jamesgao/kiln_controller/README.md

Raspberry Pi controlled Kiln
============================

This project implements a wifi-accessible temperature controller for a ceramic firing kiln.

Please see the BOM for all the parts we purchased for this project. Additional circuit diagrams and 3D models will be forthcoming.
