jamesgao/kiln_controller/circuits/pcb_eagle.png

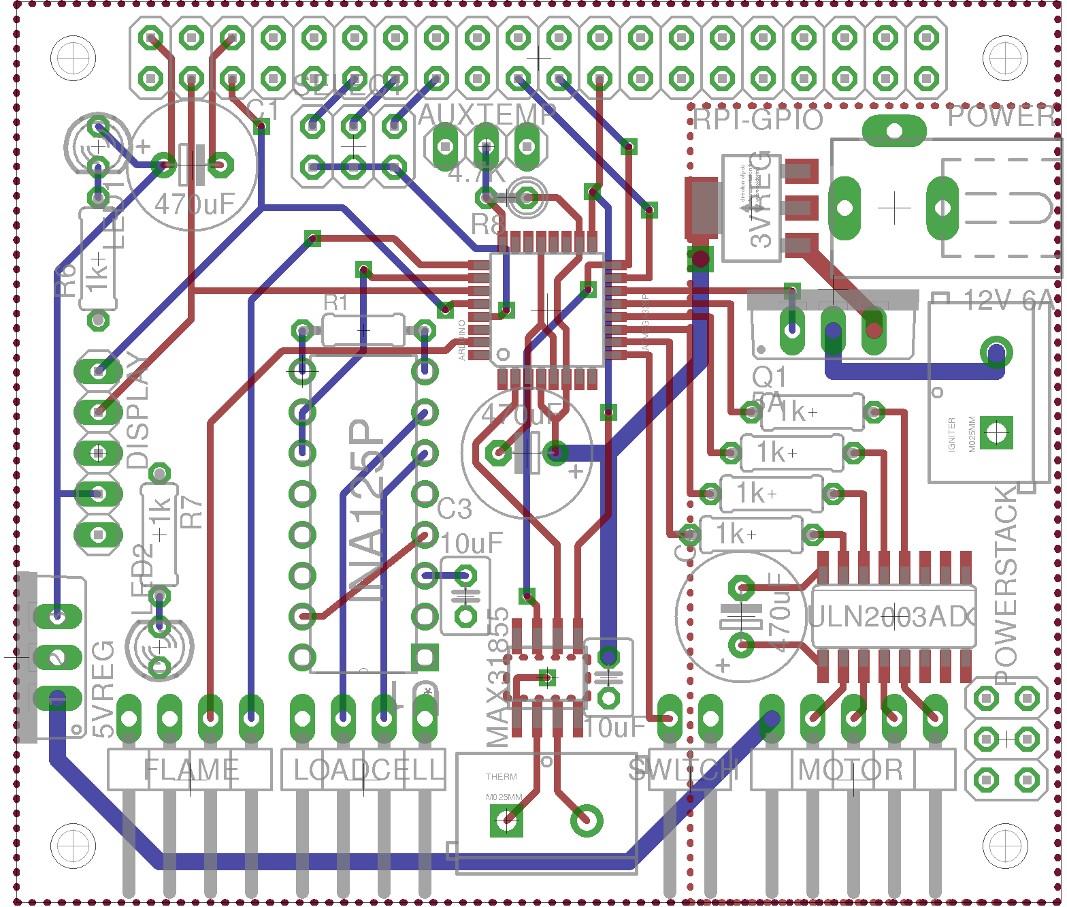
circuits/pcb_eagle.png
