jamesgao/kiln_controller/circuits/pcb_top.png

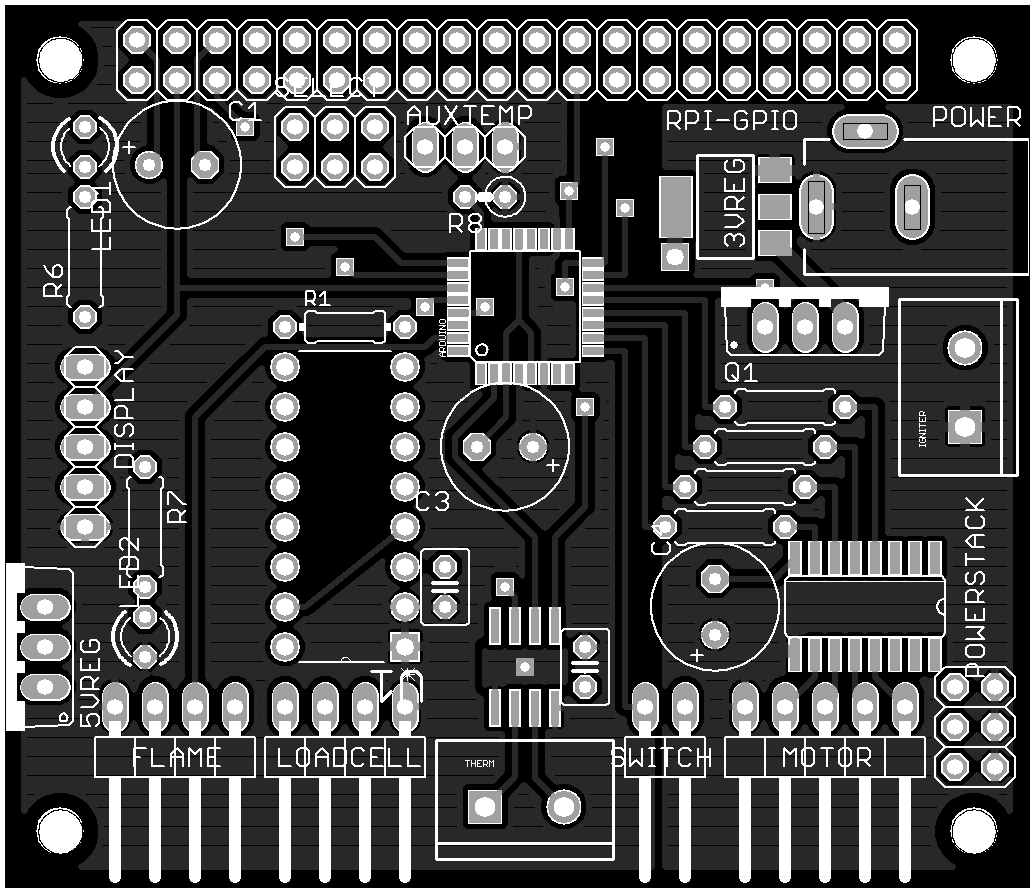
circuits/pcb_top.png
