jamesgao/kiln_controller/BOM.md

| Item | Where | Price |
|---|---|---:|
| Kiln | Craigslist| $100.00  |
|MR-750 Venturi Burner | [Link](http://www.axner.com/mr-750venturiburner.aspx) (locally purchased)| $43.50|
|Propane regulator|[Link](http://www.ebay.com/itm/331092530323?_trksid=p2060778.m2749.l2649&ssPageName=STRK%3AMEBIDX%3AIT)| $17.66|
|Various connectors| Hardware store | $10.00 |
|K-type kiln thermocouple with block|[Link](http://www.ebay.com/itm/291255615336?_trksid=p2060778.m2749.l2649&ssPageName=STRK%3AMEBIDX%3AIT)| $21.00|
|K-type thermocouple wire|[Link](http://www.amazon.com/gp/product/B00AKWP0BW/ref=oh_aui_detailpage_o03_s00?ie=UTF8&psc=1)| $9.11 |
|Raspberry Pi|[Link](http://www.newegg.com/Product/Product.aspx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)|$35.00|
|USB Wifi adapter|[Link](http://www.amazon.com/Edimax-EW-7811Un-Adapter-Raspberry-Supports/dp/B003MTTJOY)|$8.70|
|MAX31850K breakout|[Link](https://www.adafruit.com/products/1727)|$14.95|
|Alphanumeric LED with backpack|[Link](https://www.adafruit.com/products/1911)|$9.95|
|28BYJ-48 stepper|[Link](http://www.ebay.com/itm/2pcs-DC-5V-Stepper-Motor-ULN2003-Driver-Test-Module-Board-28BYJ-48-for-Arduino-/221347325924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)|$5.00|
|Silicon Nitride igniter|[Link](https://www.sparkfun.com/products/11694)|$19.95|
|Flame Sensor|[Link](http://www.ebay.com/itm/Wavelength-760nm-1100nm-LM393-IR-Flame-Fire-Sensor-Module-Board-For-Arduino-/190938428869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)|$1.50|
|12V 6A power supply|[Link](http://www.amazon.com/Adapter-Power-Supply-LCD-Monitor/dp/B003TUMDWG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)|$6.50|

*Total: $199.81*
