jamesgao/kiln_controller/BOM.ods

Item | Where | Price
Kiln | Craigslist | $100.00
MR-750 Venturi Burner | http://www.axner.com/mr-750venturiburner.aspx (locally purchased) | $43.50
Propane regulator | http://www.ebay.com/itm/331092530323?_trksid=p2060778.m2749.l2649&ssPageName=STRK%3AMEBIDX%3AIT | $17.66
Various connectors for regulator | Ace hardware | $10.00
K-type kiln thermocouple with block | http://www.ebay.com/itm/291255615336?_trksid=p2060778.m2749.l2649&ssPageName=STRK%3AMEBIDX%3AIT | $21.00
K-type thermocouple wire | http://www.amazon.com/gp/product/B00AKWP0BW/ref=oh_aui_detailpage_o03_s00?ie=UTF8&psc=1 | $9.11
Raspberry Pi | http://www.newegg.com/Product/Product.aspx?Item=N82E16813142003&nm_mc=KNC-GoogleAdwords-PC | $35.00
USB Wifi Adapter | http://www.amazon.com/Edimax-EW-7811Un-Adapter-Raspberry-Supports/dp/B003MTTJOY | $8.70
MAX31850K breakout | https://www.adafruit.com/products/1727 | $14.95
Alphanumeric LED | https://www.adafruit.com/products/1911 | $9.95
28BYJ-48 Stepper | http://www.ebay.com/itm/2pcs-DC-5V-Stepper-Motor-ULN2003-Driver-Test-Module-Board-28BYJ-48-for-Arduino-/221347325924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 | $5.00
Silicon nitride igniter | https://www.sparkfun.com/products/11694 | $19.95
Solid state relay | http://www.ebay.com/itm/141242782486?_trksid=p2060778.m2749.l2649&ssPageName=STRK%3AMEBIDX%3AIT | $3.49
Flame Sensor | http://www.ebay.com/itm/Wavelength-760nm-1100nm-LM393-IR-Flame-Fire-Sensor-Module-Board-For-Arduino-/190938428869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 | $1.50
12V 6amp power supply | http://www.amazon.com/Adapter-Power-Supply-LCD-Monitor/dp/B003TUMDWG | $6.50
 | Total | $199.81
