jamesgao/kiln_controller/models/regulator_vert.stl

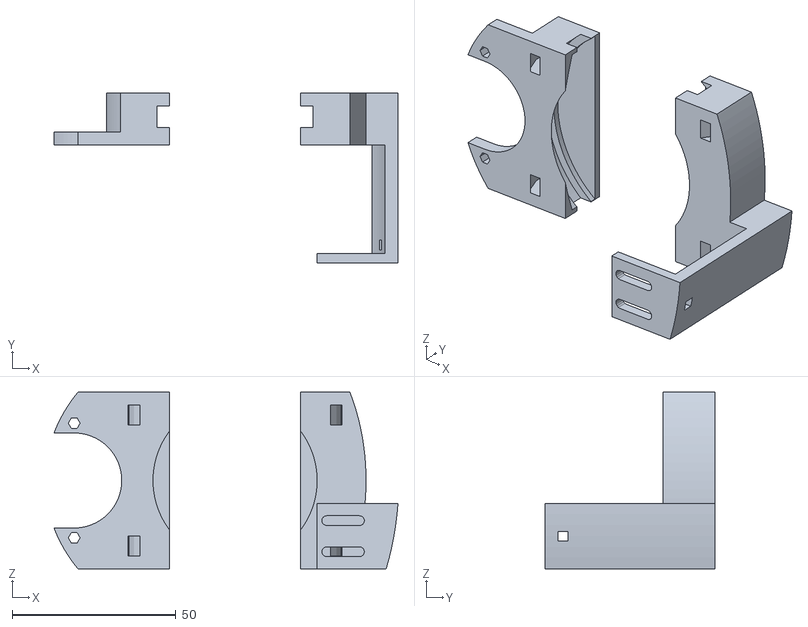
[picture p3: CAD file, 2014-11-30]
models/regulator_vert.stl
105.0 x 52.0 x 54.0
