jamesgao/kiln_controller/models/bracket.stl

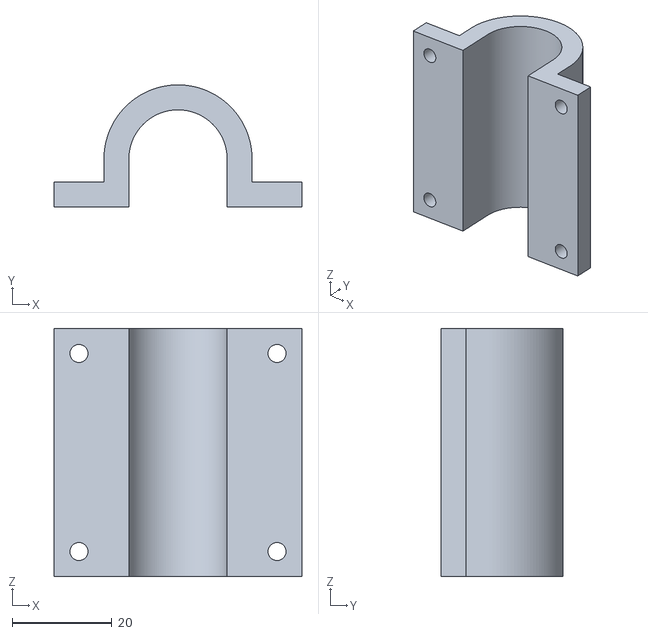
[picture p4: CAD file, 2014-10-17]
models/bracket.stl
49.7 x 24.5 x 49.7
