jamesgao/kiln_controller/models/gears.stl

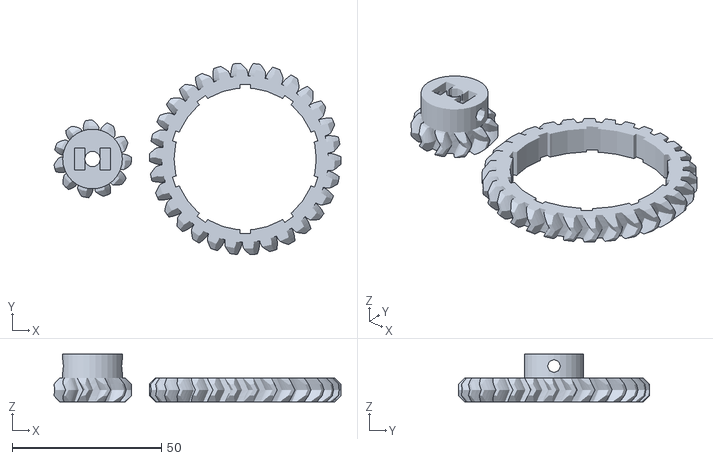
[picture p5: CAD file, 2014-10-17]
models/gears.stl
96.1 x 64.1 x 16.0
