jamesgao/kiln_controller/(list of files, cad)

Other CAD files:
models/involute_gears.scad
