jamesgao/kiln_controller/(threads)

Thread 9 (2015-06-26):

Does this code run?  Where is manager.KilnController?

Permafacture, 2015-06-26:
I'm looking at extending this code to be a more general purpose PID for kilns (Electric, propane, forced air over coals), but looking at it I see that the bisque_firing_06.py calls manager.KilnController.  But there is no KilnController Class in manager.py, or anywhere that I see.  Is this supposed to be manager.Manager?

jgimbel, 2015-06-27:
I can confirm that in February bisque_firing_06.py was working. I have not updated since then.

Permafacture, 2015-06-27:
I don't have the hardware to test this code (and won't since I'll be working with an electric kiln) but can you explain how
```
import manager
manager.KilnController(...)
```
is not an AttributeError?

Is it something that you created dynamically through the web interface or something?  If this code does run, I'd appreciate some insight.

Permafacture, 2015-06-27:
Everything looks good in general.  I like your use of threads and project layout.  Seems easily extensible.  I'm looking forward to working on this and testing it with some kilns! I have a feeling that there's an insignificant change to `manager.py` that you forgot to push though.

Thanks for this!

jamesgao, 2015-06-27:
Glad the code can be of use! I should really take some time and document this code -- there's actually a full blown web interface for controlling the kiln. If you run `python server.py` from the kiln subdirectory then navigate to http://localhost:8888/, you get a full blown temperature plot with some simple controls.

Permafacture, 2015-06-30:
So, I am working on extending this code to work on an electric kiln.  There's a lot of propane specific heuristics built in that I would like to extract out rather than just deleting.  However, I don't have a propane system to test any changes I make.  Would you be interest in me opening bugs, getting guidance from you, and making pull requests anyways?

I've opened bugs on my fork to show what I would like to do.  Feedback appreciated:

https://github.com/Permafacture/kiln_controller/issues

Thread 10 (2015-09-17):

Stepper scad file missing

jgimbel, 2015-09-17:
In regulator.scad the file '../lib/28byj.scad' is used on line 2 is missing from the git project. Adding it to the repo would help me adjust regulator.scad.
