jamesgao/kiln_controller/circuits/kiln_rpi_breakout_atmega328.brd

## EAGLE design circuits/kiln_rpi_breakout_atmega328.brd (2014-11-27)

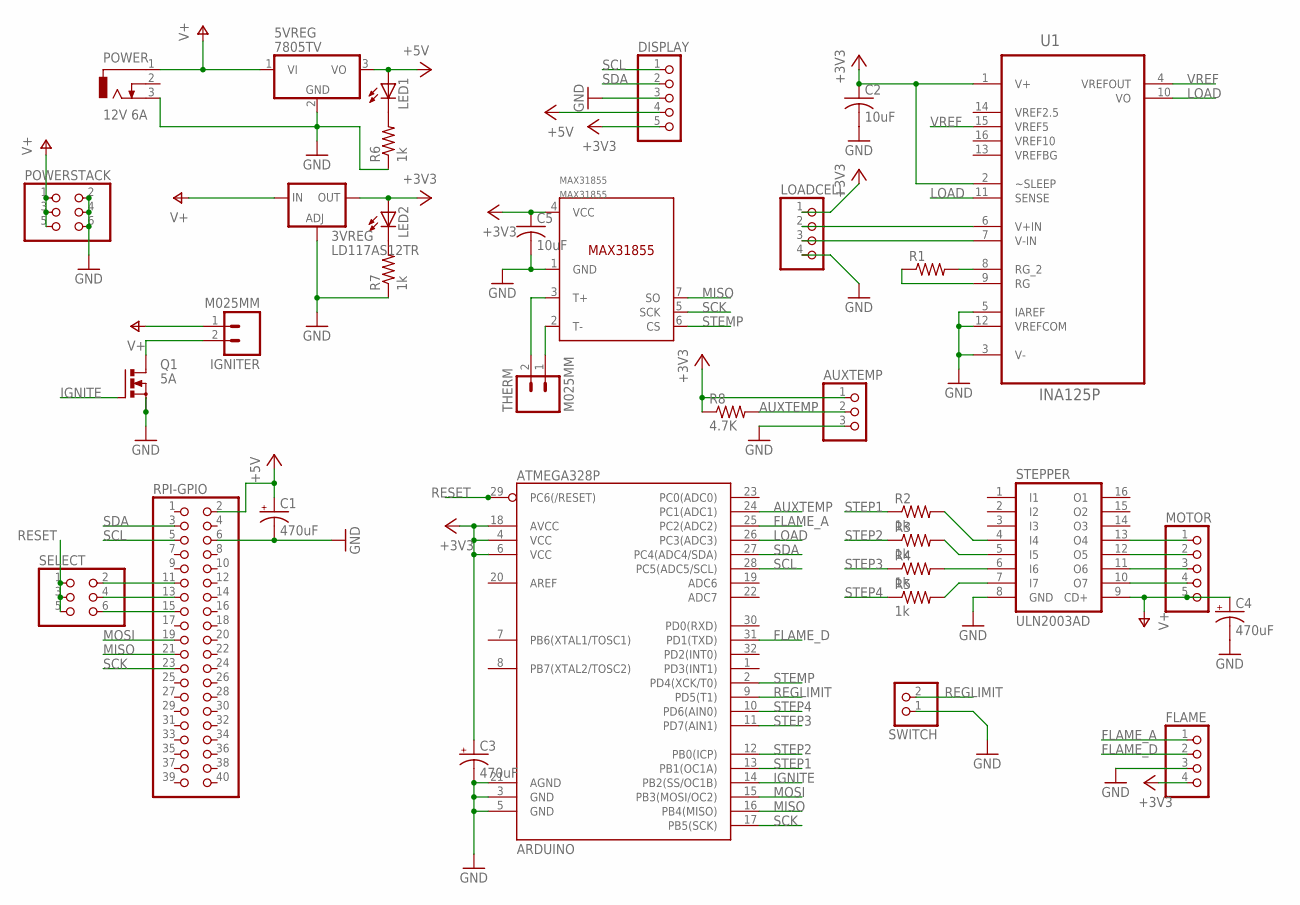
[picture p6: schematic kiln_rpi_breakout_atmega328.sch]

Parts:
3VREG: LD117AS12TR; SOT223
5VREG: 7805TV; TO220V
ARDUINO: ATMEGA328P; TQFP32-08
AUXTEMP: PINHD-1X3; 1X03
C1, C3, C4: 470uF; E3,5-8
C2, C5: 10uF; C025-030X050
DISPLAY: PINHD-1X5; 1X05
FLAME: PINHD-1X4/90; 1X04/90
IGNITER: M025MM; SCREWTERMINAL-5MM-2
LED1, LED2: LED3MM
LOADCELL: PINHD-1X4/90; 1X04/90
MAX31855: MAX31855; SOIC8
MOTOR: PINHD-1X5/90; 1X05/90
POWER: 12V 6A; DCJ0303
POWERSTACK: PINHD-2X3; 2X03
Q1: 5A; TO220BV
R1: R-US_0204/7; 0204/7
R2, R3, R4, R5, R6, R7: 1k; 0207/7
R8: 4.7K; 0207/2V
RPI-GPIO: PINHD-2X20; 2X20
SELECT: PINHD-2X3; 2X03
STEPPER: ULN2003AD; SO16
SWITCH: PINHD-1X2/90; 1X02/90
THERM: M025MM; SCREWTERMINAL-5MM-2
U1: INA125P; DIP254P762X508-16

Connections:
+3V3: 3VREG.4 (OUT), ARDUINO.4 (VCC), ARDUINO.6 (VCC), ARDUINO.18 (AVCC), AUXTEMP.1, C2.1, C3.+, C5.1, DISPLAY.5, FLAME.4, LED2.A, LOADCELL.1, MAX31855.4 (VCC), R8.1, U1.1 (V+), U1.2 (~SLEEP)
+5V: 5VREG.3 (VO), C1.+, DISPLAY.4, LED1.A, RPI-GPIO.2
AUXTEMP: ARDUINO.24 (PC1(ADC1)), AUXTEMP.2, R8.2
FLAME_A: ARDUINO.25 (PC2(ADC2)), FLAME.1
FLAME_D: ARDUINO.31 (PD1(TXD)), FLAME.2
GND: 3VREG.1 (ADJ), 5VREG.2 (GND), ARDUINO.3 (GND), ARDUINO.5 (GND), ARDUINO.21 (AGND), AUXTEMP.3, C1.-, C2.2, C3.-, C4.-, C5.2, DISPLAY.3, FLAME.3, LOADCELL.4, MAX31855.1 (GND), POWER.3, POWERSTACK.2, POWERSTACK.4, POWERSTACK.6, Q1.S, R6.1, R7.1, RPI-GPIO.6, STEPPER.8 (GND), SWITCH.1, U1.3 (V-), U1.5 (IAREF), U1.12 (VREFCOM)
IGNITE: ARDUINO.14 (PB2(SS/OC1B)), Q1.G
LOAD: ARDUINO.26 (PC3(ADC3)), U1.10 (VO), U1.11 (SENSE)
MISO: ARDUINO.16 (PB4(MISO)), MAX31855.7 (SO), RPI-GPIO.21
MOSI: ARDUINO.15 (PB3(MOSI/OC2)), RPI-GPIO.19
unnamed: MOTOR.1, STEPPER.13 (O4)
unnamed: MOTOR.2, STEPPER.12 (O5)
unnamed: MOTOR.3, STEPPER.11 (O6)
unnamed: MOTOR.4, STEPPER.10 (O7)
unnamed: LED1.K (C), R6.2
unnamed: LOADCELL.2, U1.6 (V+IN)
unnamed: LOADCELL.3, U1.7 (V-IN)
unnamed: MAX31855.3 (T+), THERM.2
unnamed: IGNITER.2, Q1.D
unnamed: R1.2, U1.8 (RG_2)
unnamed: R5.2, STEPPER.7 (I7)
unnamed: R4.2, STEPPER.6 (I6)
unnamed: R3.2, STEPPER.5 (I5)
unnamed: R2.2, STEPPER.4 (I4)
unnamed: R1.1, U1.9 (RG)
unnamed: MAX31855.2 (T-), THERM.1
unnamed: LED2.K (C), R7.2
REGLIMIT: ARDUINO.9 (PD5(T1)), SWITCH.2
RESET: ARDUINO.29 (PC6(/RESET)), SELECT.1, SELECT.3, SELECT.5
RESET1: RPI-GPIO.11, SELECT.2
RESET2: RPI-GPIO.13, SELECT.4
RESET3: RPI-GPIO.15, SELECT.6
SCK: ARDUINO.17 (PB5(SCK)), MAX31855.5 (SCK), RPI-GPIO.23
SCL: ARDUINO.28 (PC5(ADC5/SCL)), DISPLAY.1, RPI-GPIO.5
SDA: ARDUINO.27 (PC4(ADC4/SDA)), DISPLAY.2, RPI-GPIO.3
STEMP: ARDUINO.2 (PD4(XCK/T0)), MAX31855.6 (CS)
STEP1: ARDUINO.13 (PB1(OC1A)), R2.1
STEP2: ARDUINO.12 (PB0(ICP)), R3.1
STEP3: ARDUINO.11 (PD7(AIN1)), R4.1
STEP4: ARDUINO.10 (PD6(AIN0)), R5.1
V+: 3VREG.3 (IN), 5VREG.1 (VI), C4.+, IGNITER.1, MOTOR.5, POWER.1, POWERSTACK.1, POWERSTACK.3, POWERSTACK.5, STEPPER.9 (CD+)
VREF: U1.4 (VREFOUT), U1.15 (VREF5)
VREF2.5: U1.14 (VREF2.5)
VREF10: U1.16 (VREF10)
VREFBG: U1.13 (VREFBG)

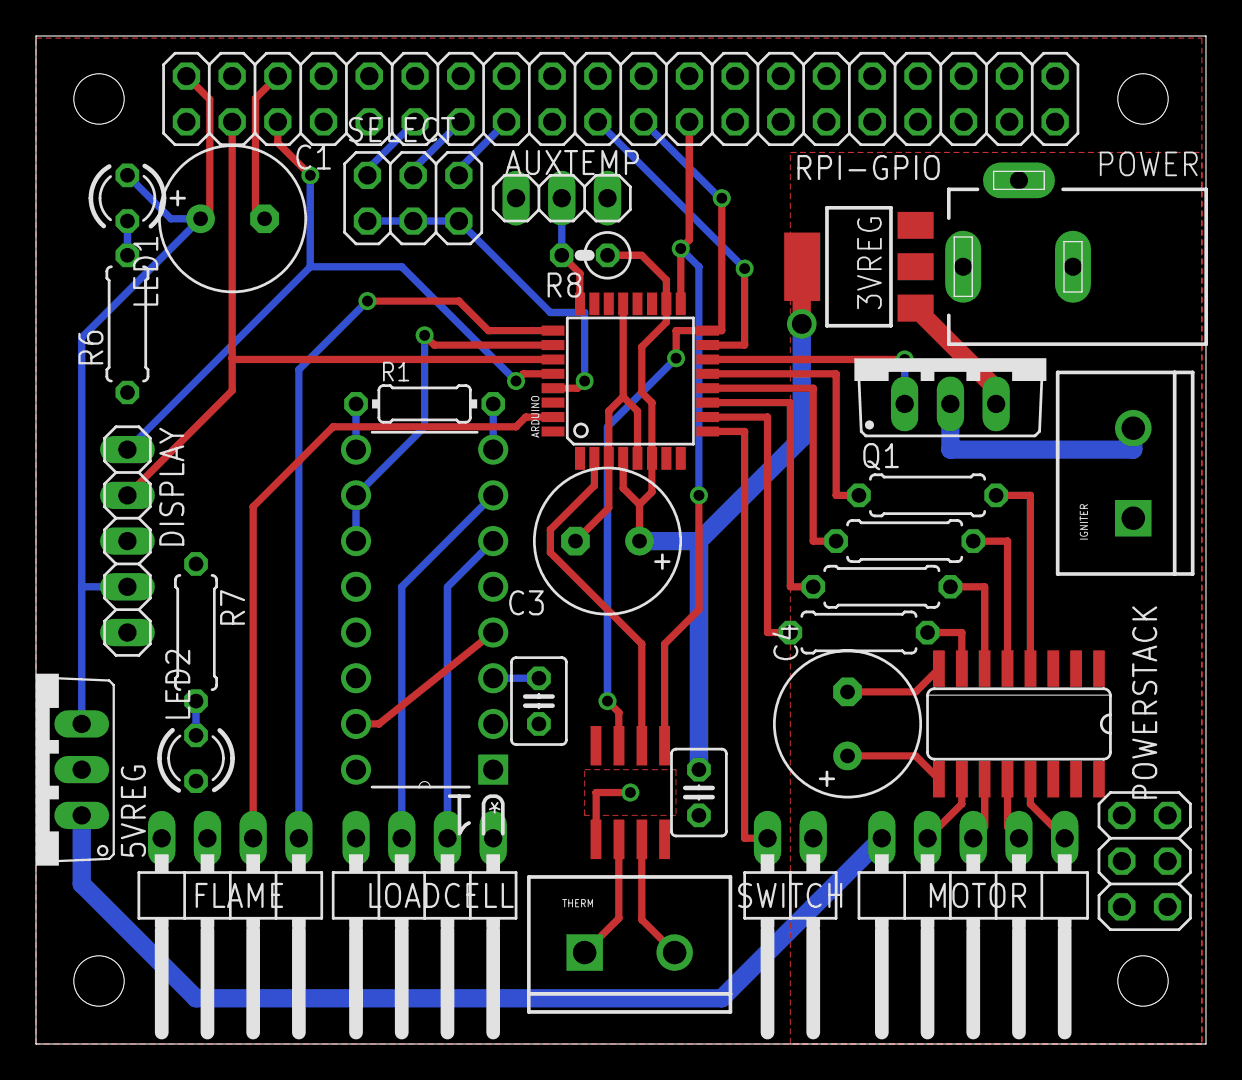
[picture p7: board kiln_rpi_breakout_atmega328.brd from above]

Board: 2 copper layers, 65.0 x 56.0 mm, 34 parts (0 on the bottom side), 42 nets.
