jamesgao/kiln_controller/kiln/Adafruit_alphanumeric.py

#!/usr/bin/python
import threading
import time
import datetime
from Adafruit_LEDBackpack import LEDBackpack

# ===========================================================================
# Alphanumeric Display
# ===========================================================================

# This class is meant to be used with the 4-character alphanumeric
# displays available from Adafruit

class Alphanumeric(object):
    disp = None
 
    # Hexadecimal character lookup table
    lut = [
        0b0000000000000001,
        0b0000000000000010,
        0b0000000000000100,
        0b0000000000001000,
        0b0000000000010000,
        0b0000000000100000,
        0b0000000001000000,
        0b0000000010000000,
        0b0000000100000000,
        0b0000001000000000,
        0b0000010000000000,
        0b0000100000000000,
        0b0001000000000000,
        0b0010000000000000,
        0b0100000000000000,
        0b1000000000000000,
        0b0000000000000000,
        0b0000000000000000,
        0b0000000000000000,
        0b0000000000000000,
        0b0000000000000000,
        0b0000000000000000,
        0b0000000000000000,
        0b0000000000000000,
        0b0001001011001001,
        0b0001010111000000,
        0b0001001011111001,
        0b0000000011100011,
        0b0000010100110000,
        0b0001001011001000,
        0b0011101000000000,
        0b0001011100000000,
        0b0000000000000000, #
        0b0000000000000110, # !
        0b0000001000100000, # "
        0b0001001011001110, # #
        0b0001001011101101, # $
        0b0000110000100100, # %
        0b0010001101011101, # &
        0b0000010000000000, # '
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
                
    special = dict(degree= 0b0000000011100011, cone=0b0010100000001000)
    
    def __init__(self, address=0x70, debug=False):
        self.disp = LEDBackpack(address=address, debug=debug)

    def writeCharRaw(self, charNumber, value):
        "Sets a digit using the raw 16-bit value"
        if (charNumber > 4):
            return
        # Set the appropriate digit
        self.disp.setBufferRow(charNumber, value)

    def writeChar(self, charNumber, value, dot=False):
        "Sets a single decimal or hexademical value (0..9 and A..F)"
        if (charNumber > 4):
            return
        if value in self.special:
            value = self.special[value]
        else:
            value = self.lut[ord(value)]
        # Set the appropriate digit
        self.disp.setBufferRow(charNumber, value | (dot << 14))

class AlphaScroller(threading.Thread):
    def __init__(self, address=0x70, interval=.25):
        self.interval = interval
        self.disp = Alphanumeric(address)
        self.text = ''
        self.counter = 0
        self.pause = threading.Event()
        self.pause.set()
        self.shown = True

        super(AlphaScroller, self).__init__()
        self.running = True

    def stop(self):
        self.pause.set()
        self.running = False
    
    def set_text(self, text, pad=True, reset=True):
        i = 0
        self.text = []
        while i < len(text):
            if i+1 < len(text) and text[i+1] == ".":
                self.text.append((text[i], True))
                i+= 1
            else:
                self.text.append((text[i],))
            i+= 1

        if pad:
            self.text += [(' ',)]*4

        if reset:
            self.counter = 0
    
    def set_speed(self, interval):
        self.interval = interval

    def show(self):
        self.pause.set()
        self.shown = True

    def hide(self):
        self.pause.clear()
        self.clear()
        self.shown = False

    def clear(self):
        for i in range(4):
            self.disp.writeChar(i, ' ')
    
    def run(self):
        while self.running:
            for i in range(4):
                if len(self.text) < 4:
                    char = self.text[i] if i < len(self.text) else (' ',)
                else:
                    char = self.text[(self.counter+i) % len(self.text)]
                if len(char[0]) == 0:
                    print self.text
                self.disp.writeChar(i, *char)
            time.sleep(self.interval)
            self.counter += 1
            self.pause.wait()
        self.clear()

if __name__ == "__main__":
    scroller = AlphaScroller(interval=.4)
    scroller.set_text(list("Hello. World.")+["cone","degree"])
    scroller.start()
    try:
        while scroller.isAlive():
            scroller.join(1)
    except KeyboardInterrupt:
        scroller.stop()
