jamesgao/kiln_controller/kiln/manager.py

import os
import stepper
import time
import random
import thermo
import threading
import traceback
import logging

import states
import PID

logger = logging.getLogger(__name__)
logger.setLevel(logging.INFO)

class TempLog(object):
	def __init__(self, history, interval=60, suffix=""): #save data every 60 seconds
		import paths
		self.history = history
		fname = time.strftime('%Y-%m-%d_%I:%M%P')
		if len(suffix) > 0:
			suffix = "_"+suffix
		self.fname = os.path.join(paths.log_path, fname+suffix+".log")
		with open(self.fname, 'w') as fp:
			fp.write("time\ttemp\n")
			for t, temp in history:
				fp.write("%f\t%f\n"%(t, temp))
		self.next = time.time() + interval
		self.interval = interval
		self._buffer = []

	def __iter__(self):
		return iter(self.history)

	def append(self, data):
		self.history.append(data)
		self._buffer.append(data)
		if time.time() > self.next:
			with open(self.fname, 'a') as fp:
				for t, temp in self._buffer:
					fp.write("%f\t%f\n"%(t, temp))
			self._buffer = []
			self.next = time.time() + self.interval

class Manager(threading.Thread):
	def __init__(self, start=states.Idle, simulate=False):
		"""
		Implement a state machine that cycles through States
		"""
		super(Manager, self).__init__()
		self._send = None
		
		if simulate:
			self.regulator = stepper.Regulator(simulate=simulate)
			self.therm = thermo.Simulate(regulator=self.regulator)
		else:
			self.regulator = stepper.Breakout(0x08)
			self.therm = thermo.Breakout(0x08)

		self.state = start(self)
		self.state_change = threading.Event()

		self.running = True
		self.start()

	def notify(self, data):
		if self._send is not None:
                        try:
			     self._send(data)
                        except:
                             pass
		else:
			logger.info("No notifier set, ignoring message: %s"%data)

	def __getattr__(self, name):
		"""Mutates the manager to return State actions
		If the requested attribute is a function, wrap the function
		such that returned obejcts which are States indicate a state change
		"""
		attr = getattr(self.state, name)
		if hasattr(attr, "__call__"):
			def func(*args, **kwargs):
				self._change_state(attr(*args, **kwargs))
			return func

		return attr

	def _change_state(self, output):
		if isinstance(output, type) and issubclass(output, states.State) :
			self.state = output(self)
			self.state_change.set()
			self.notify(dict(type="state", state=output.__name__))
			logger.info("Switching to state '%s'"%output.__name__)
		elif isinstance(output, tuple) and issubclass(output[0], states.State):
			newstate, kwargs = output
			self.state = newstate(self, **kwargs)
			self.notify(dict(type="state", state=newstate.__name__))
			logger.info("Switching to state '%s'"%newstate.__name__)
		elif isinstance(output, dict) and "type" in output:
			self.notify(output)
		elif output is not None:
			logger.warn("Unknown state output: %r"%output)

	def run(self):
		while self.running:
			self._change_state(self.state.run())
	
	def manager_stop(self):
		self.running = False
		self.state_change.set()

class Profile(threading.Thread):
	"""Performs the PID loop required for feedback control"""
	def __init__(self, schedule, therm, regulator, interval=1, start_time=None, callback=None,
			Kp=.03, Ki=.015, Kd=.001):
		super(Profile, self).__init__()
		self.daemon = True

		self.schedule = schedule
		self.therm = therm
		self.regulator = regulator
		self.interval = interval
		self.start_time = start_time
		if start_time is None:
			self.start_time = time.time()

		self.pid = PID.PID(Kp, Ki, Kd)
		self.callback = callback
		self.running = True
		self.duty_cycle = False
		self.start()

	@property
	def elapsed(self):
		''' Returns the elapsed time from start in seconds'''
		return time.time() - self.start_time

	@property
	def completed(self):
		return self.elapsed > self.schedule[-1][0]

	def stop(self):
		self.running = False

	def run(self):
		_next = time.time()+self.interval
		while not self.completed and self.running:
			ts = self.elapsed
			#find epoch
			for i in range(len(self.schedule)-1):
				if self.schedule[i][0] < ts < self.schedule[i+1][0]:
					time0, temp0 = self.schedule[i]
					time1, temp1 = self.schedule[i+1]
					frac = (ts - time0) / (time1 - time0)
					setpoint = frac * (temp1 - temp0) + temp0
					self.pid.setPoint(setpoint)

					temp = self.therm.temperature.temp
					if temp == -1:
						continue #skip invalid temperature readings
					elif temp - setpoint > 10:
						self.regulator.off()
						self.duty_cycle = True
						pid_out = -1
					elif self.duty_cycle:
						if temp - setpoint < -5:
							self.regulator.ignite()
							self.duty_cycle = False
						pid_out = -1
					else:
						pid_out = self.pid.update(temp)
						if pid_out < 0: pid_out = 0
						if pid_out > 1: pid_out = 1
						self.regulator.set(pid_out)

					if self.callback is not None:
						self.callback(temp, setpoint, pid_out)

			sleep = _next - time.time()
			if sleep > 0:
				time.sleep(sleep)
			_next += self.interval
