jamesgao/kiln_controller/(commit log)

2014-10-15 Implement the stepper-controlled regulator function
2014-10-15 Set up stepper.py for the limits
2014-10-15 Add additional LED code
2014-10-15 Add current thermocouple reading code
2014-10-16 created KilnController class which sets the kiln temperature according to a schedule using PID temperature control
2014-10-16 Adding temp monitor code
    [BOM.ods]
2014-10-16 Fixing threading, dot rendering
    [Adafruit_alphanumeric.py, thermo.py]
2014-10-16 Working thermo.py with LED scroller
2014-10-16 Only display temperature above 50 C
2014-10-17 update nonblocking stepper, damn is bootstrap sexy
2014-10-17 working on d3 graph for temperature
2014-10-17 Add the scad and stl files for kiln parts
    [bracket.scad, bracket.stl, gears.scad, gears.stl, involute_gears.scad, regulator.scad, regulator_vert.stl, utils.scad]
2014-10-18 Forgot to fix the thermocouple display
    [thermo.py]
2014-10-18 Fix bugs in stepper
    [stepper.py]
2014-10-18 Still fixing small bugs in stepper, now tested
    [stepper.py]
2014-10-18 Add a bunch of simulation code to test PID
2014-10-18 add temperature logging with a file
2014-10-20 testing temperature streaming
2014-10-20 working server for streaming temperature data
2014-10-20 Attempting to fix #1
    [manager.py, server.py]
2014-10-22 Convert BOM to markdown
2014-10-22 Add power supply, total to BOM.md
2014-10-22 Backend state machine finished, untested
    [BOM.ods]
2014-10-26 Add code / model for a limit switch
    [regulator.scad, regulator_vert.stl]
2014-10-29 Finished circuit boards sent out
    Finally finished the circuit board design. I ended up going with a
    pretty different approach than I was originally planning, since this
    design is low impact and allows board stacking. An ATMEGA328 chip
    running as an I2C slave will be the primary communication between the
    raspberry pi and the hardware, instead of the raspberry pi directly
    controlling the hardware. Code changes to accommodate will be
    forthcoming, although this works towards allowing multi-zone heating
    [kiln_rpi_breakout_atmega328.brd, kiln_rpi_breakout_atmega328.sch]
2014-10-29 Add auxtemp header, stacking power connector
    Managed to update the pcb order in time. Auxtemp header takes a DS18B20
    chip as an auxiliary temperature monitor, good for checking for propane
    tank freezing or even as primary temperature control. Additional
    powerstack header allows stacked breakouts to pass power between boards
    [kiln_rpi_breakout_atmega328.brd, kiln_rpi_breakout_atmega328.sch]
2014-11-02 Schedule saving complete, add pcb images
    Most of the UI elements behave as expected, but setting the Running
    state is not yet complete. Still need to work out how to deal with the
    profile names on the server side. Added a couple of images for the PCB.
    Rendered version of the pcb is care of dirtypcb.com, where I ordered the
    first batch of PCBs. The other image is rendered via EagleCAD.
2014-11-27 Adding firmware interface for circuitboard
2014-11-27 Add preliminary arduino firmware code
2014-11-29 Software now supports breakout board
2014-11-29 Fixes to make new code work with actual device
    [manager.py, server.py, thermo.py]
2014-11-30 Working profile running, events still need work
    [regulator.scad, regulator_vert.stl]
2014-11-30 Fix defaults again, first ones were errant
    [stepper.py]
2014-11-30 Add some spike detection in temperature
2014-12-17 Bug fixes from last firing
    [PID.py, breakout.py, manager.py, server.py, stepper.py, thermo.py]
2015-02-22 added graph.resample method to prevent browser crash from trying to plot too many points
    [temp_graph.js]
2015-02-22 interpolate minstep for temperature
2015-02-22 lower the min motor
2015-02-22 Lower limits for stepper
2015-02-22 Only re-ignite if temperature at least 20 degrees below setpoint
2015-02-22 logic error in duty cycling
    [manager.py]
2015-02-22 Better timing for PID loop
